Chrismettal/ESP-Hiro/PCB/OtherDesigns-DebugPrototypes/DC-DC-only/DC-DC-only.kicad_pcb

## KiCad design PCB/OtherDesigns-DebugPrototypes/DC-DC-only/DC-DC-only.kicad_pcb (2021-02-06)

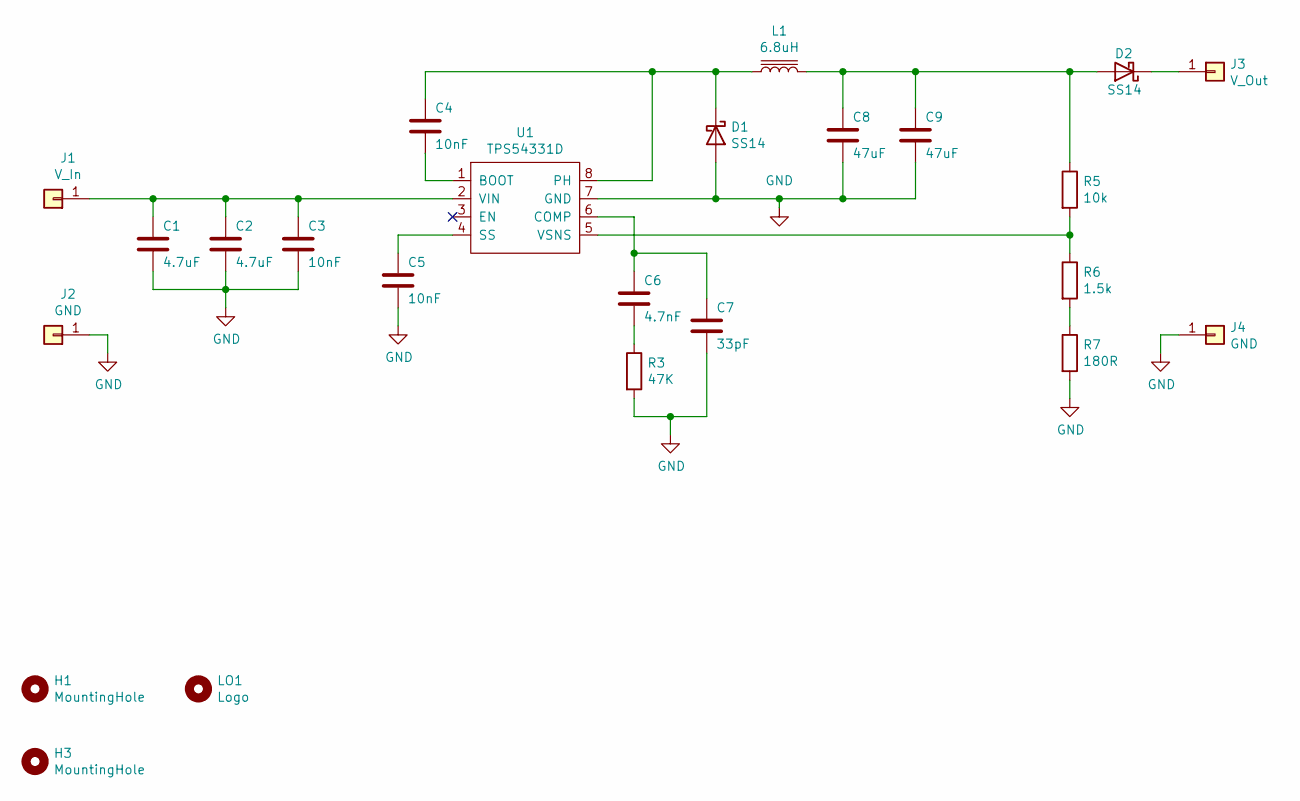
[picture p3: schematic DC-DC-only.kicad_sch]

Parts:
C1, C2: 4.7uF; C_1206_3216Metric; LCSC C29823
C3, C4, C5: 10nF; C_0603_1608Metric; LCSC C57112
C6: 4.7nF; C_0603_1608Metric; LCSC C53987
C7: 33pF; C_0603_1608Metric; LCSC C1663
C8, C9: 47uF; C_1206_3216Metric; LCSC C96123
D1, D2: SS14; D_SMA; LCSC C2480
H1, H3: MountingHole; EigenesMountingHole_2.7mm_M2.5
J1: V_In; PinheaderOwn
J2, J4: GND; PinheaderOwn
J3: V_Out; PinheaderOwn
L1: 6.8uH; Sunltech_SLO0630H; LCSC C207841
LO1: Logo; Binary_6_v0.1
R3: 47K; R_0603_1608Metric; LCSC C25819
R5: 10k; R_0603_1608Metric; LCSC C25804
R6: 1.5k; R_0603_1608Metric; LCSC C22843
R7: 180R; R_0603_1608Metric; LCSC C22828
U1: TPS54331D; SOIC-8_3.9x4.9mm_P1.27mm; LCSC C9865

Connections:
GND: C1.2, C2.2, C3.2, C5.2, C7.2, C8.2, C9.2, D1.2 (A), J2.1, J4.1, R3.2, R7.2, U1.7 (GND)
unnamed: C1.1, C2.1, C3.1, J1.1, U1.2 (VIN)
unnamed: C4.1, D1.1 (K), L1.1, U1.8 (PH)
unnamed: C5.1, U1.4 (SS)
unnamed: C6.1, C7.1, U1.6 (COMP)
unnamed: C6.2, R3.1
unnamed: C8.1, C9.1, D2.2 (A), L1.2, R5.1
unnamed: D2.1 (K), J3.1
unnamed: R5.2, R6.1, U1.5 (VSNS)
unnamed: R6.2, R7.1
unnamed: C4.2, U1.1 (BOOT)

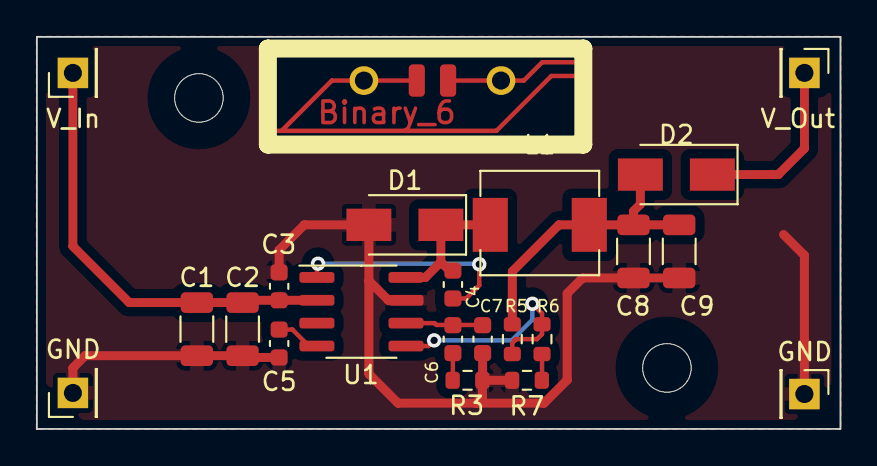
[picture p4: board DC-DC-only.kicad_pcb from above]

Board: 2 copper layers, 44.6 x 21.8 mm, 24 parts (0 on the bottom side), 11 nets.
