Chrismettal/ESP-Hiro/PCB/OtherDesigns-DebugPrototypes/USB-CP2102-only/USB-CP2102-only.kicad_pcb

## KiCad design PCB/OtherDesigns-DebugPrototypes/USB-CP2102-only/USB-CP2102-only.kicad_pcb (2021-02-06)

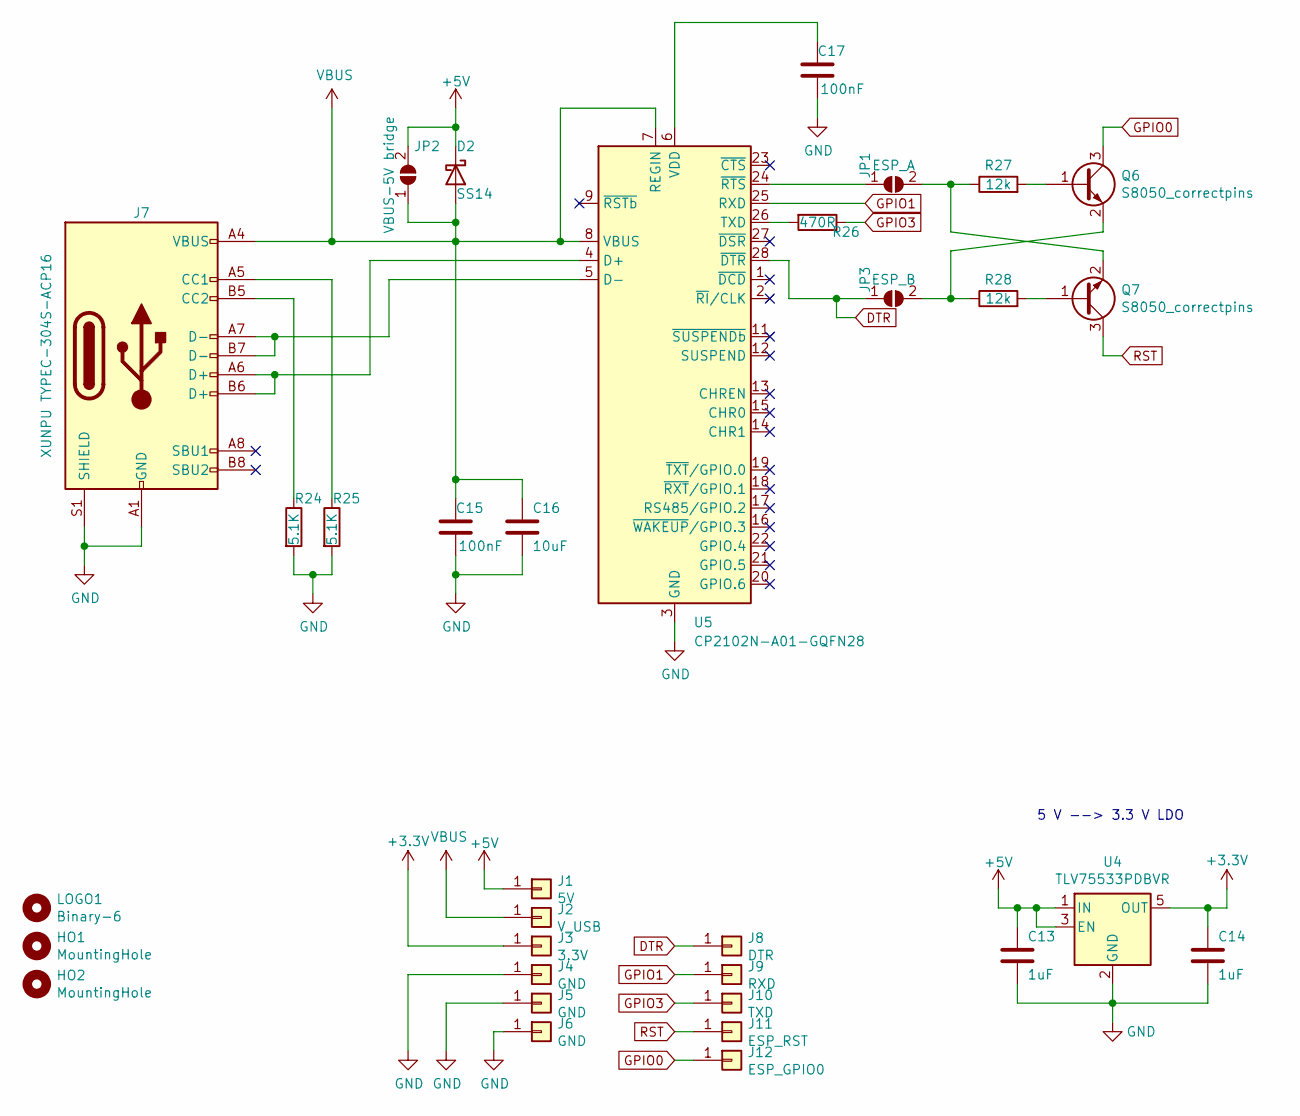
[picture p5: schematic USB-CP2102-only.kicad_sch, ESP-Hiro]

Parts:
C13, C14: 1uF; C_0603_1608Metric; LCSC C15849
C15, C17: 100nF; C_0603_1608Metric; LCSC C14663
C16: 10uF; C_1206_3216Metric; LCSC C13585
D2: SS14; D_SMA; LCSC C2480
HO1, HO2: MountingHole; EigenesMountingHole_2.7mm_M2.5
J1: 5V; PinheaderOwn
J2: V_USB; PinheaderOwn
J3: 3.3V; PinheaderOwn
J4, J5, J6: GND; PinheaderOwn
J7: XUNPU TYPEC-304S-ACP16; USB_C_Receptacle_XUNPU_TYPEC-304S-ACP16; LCSC C720630
J8: DTR; PinheaderOwn
J9: RXD; PinheaderOwn
J10: TXD; PinheaderOwn
J11: ESP_RST; PinheaderOwn
J12: ESP_GPIO0; PinheaderOwn
JP1: ESP_A; SolderJumper-2_P1.3mm_Open_TrianglePad1.0x1.5mm
JP2: VBUS-5V bridge; SolderJumper-2_P1.3mm_Open_TrianglePad1.0x1.5mm
JP3: ESP_B; SolderJumper-2_P1.3mm_Open_TrianglePad1.0x1.5mm
LOGO1: Binary-6; LOGO
Q6, Q7: S8050_correctpins; SOT-23; LCSC C2150
R24, R25: 5.1K; R_0603_1608Metric; LCSC C23186
R26: 470R; R_0603_1608Metric; LCSC C23179
R27, R28: 12k; R_0603_1608Metric; LCSC C22790
U4: TLV75533PDBVR; SOT-23-5; LCSC C404027
U5: CP2102N-A01-GQFN28; QFN-28-1EP_5x5mm_P0.5mm_EP3.35x3.35mm; LCSC C6568

Connections:
+3V3: C14.1, J3.1, U4.5 (OUT)
+5V: C13.1, D2.1 (K), J1.1, JP2.2 (B), U4.1 (IN), U4.3 (EN)
DTR: J8.1, JP3.1 (A), U5.28 (~DTR)
GND: C13.2, C14.2, C15.1, C16.2, C17.1, J4.1, J5.1, J6.1, J7.A1 (GND), J7.A12 (GND), J7.B1 (GND), J7.B12 (GND), J7.S1 (SHIELD), R24.2, R25.2, U4.2 (GND), U5.3 (GND), U5.29 (GND)
GPIO0: J12.1, Q6.3 (C)
GPIO1: J9.1, U5.25 (RXD)
GPIO3: J10.1, R26.1
unnamed: C17.2, U5.6 (VDD)
unnamed: J7.A5 (CC1), R25.1
unnamed: J7.A6 (D+), J7.B6 (D+), U5.4 (D+)
unnamed: J7.A7 (D-), J7.B7 (D-), U5.5 (D-)
unnamed: J7.B5 (CC2), R24.1
unnamed: JP1.1 (A), U5.24 (~RTS)
unnamed: JP1.2 (B), Q7.2 (E), R27.1
unnamed: JP3.2 (B), Q6.2 (E), R28.1
unnamed: Q6.1 (B), R27.2
unnamed: Q7.1 (B), R28.2
unnamed: R26.2, U5.26 (TXD)
RST: J11.1, Q7.3 (C)
VBUS: C15.2, C16.1, D2.2 (A), J2.1, J7.A4 (VBUS), J7.A9 (VBUS), J7.B4 (VBUS), J7.B9 (VBUS), JP2.1 (A), U5.7 (REGIN), U5.8 (VBUS)

Notes on the sheet:
5 V --> 3.3 V LDO

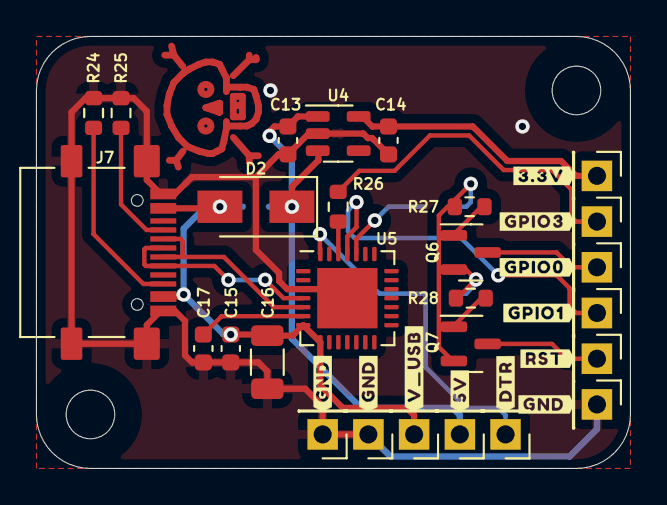
[picture p6: board USB-CP2102-only.kicad_pcb from above]

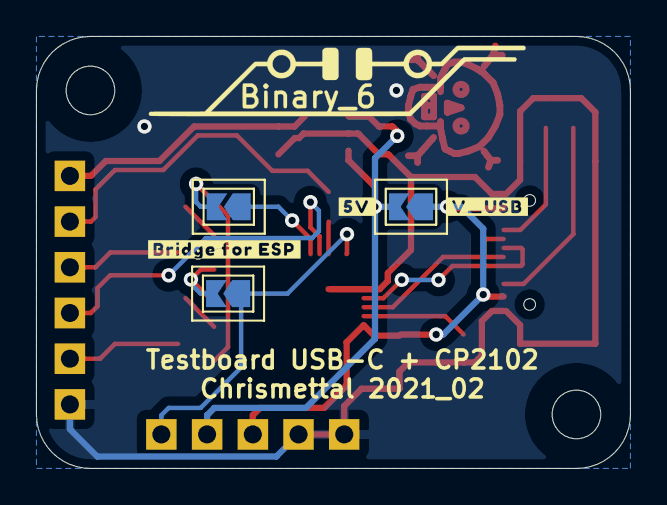
[picture p7: board USB-CP2102-only.kicad_pcb from below]

Board: 2 copper layers, 33.0 x 24.0 mm, 33 parts (4 on the bottom side), 20 nets.
